mrmanfreee/LightioCurtainsController/3d-models/PulleyBlock/asm.gif

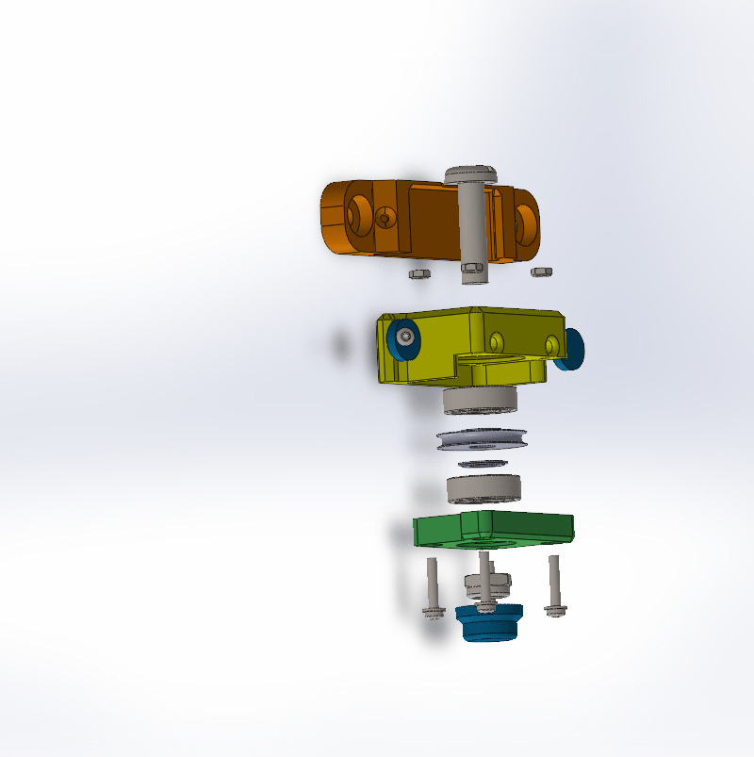
3d-models/PulleyBlock/asm.gif
