mrmanfreee/LightioCurtainsController/3d-models/PulleyBlock/asm.png

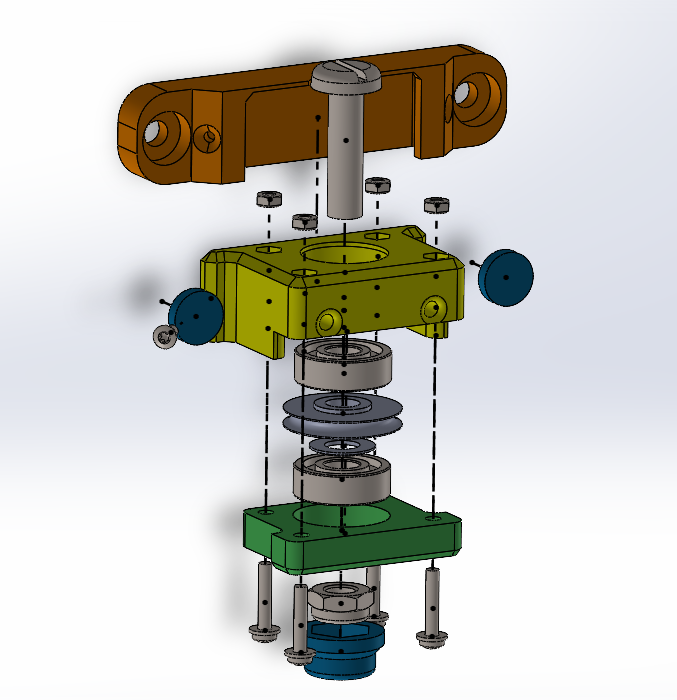
3d-models/PulleyBlock/asm.png
