mrmanfreee/LightioCurtainsController/3d-models/AdditionalDetails/small.3mf

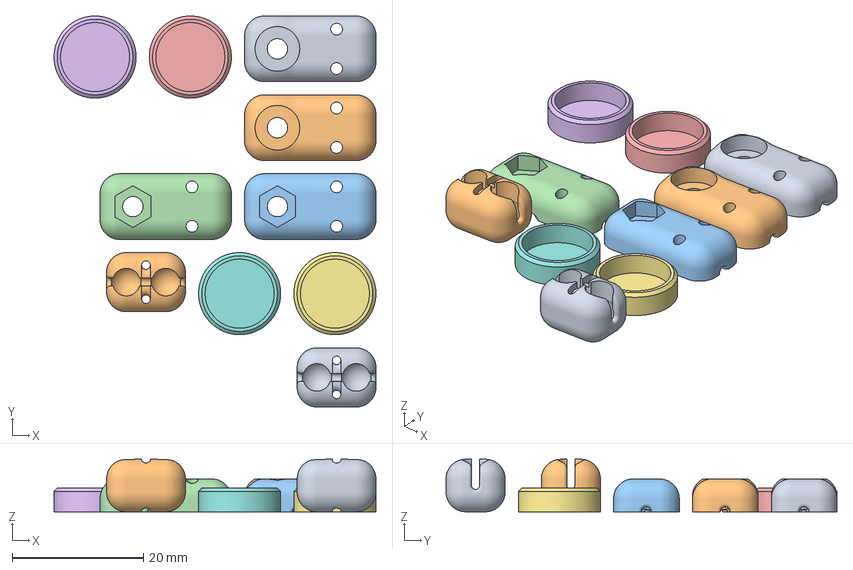
[picture p16: CAD file, 2026-11-05]
3d-models/AdditionalDetails/small.3mf
49.0 x 59.5 x 8.00 mm
connectorTopBall x 2
connectorBtmBall x 2
cap x 4
presser x 2
