mrmanfreee/LightioCurtainsController/3d-models/Controller/MirrorGateBall.STEP

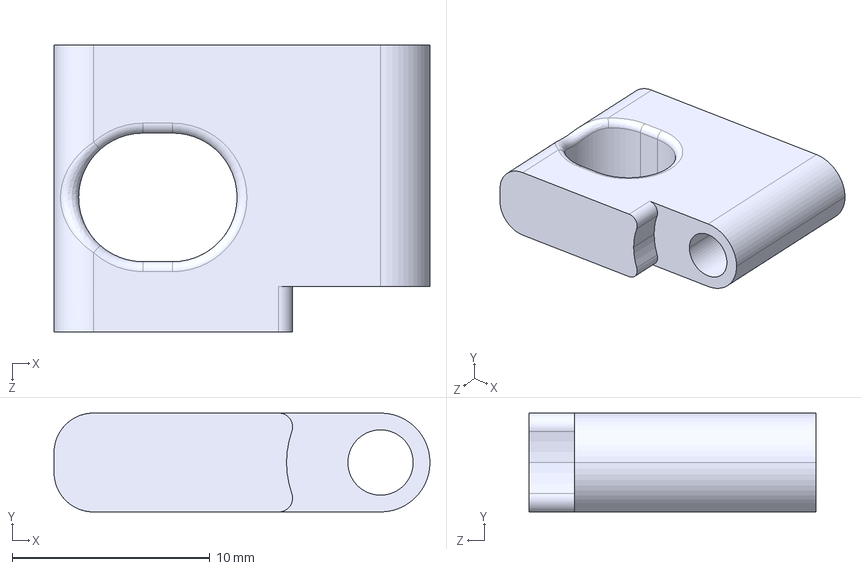
[picture p17: CAD file, 2026-11-05]
3d-models/Controller/MirrorGateBall.STEP
19.0 x 5.00 x 14.5 mm
