mrmanfreee/LightioCurtainsController/3d-models/Remote/buttonA.STEP

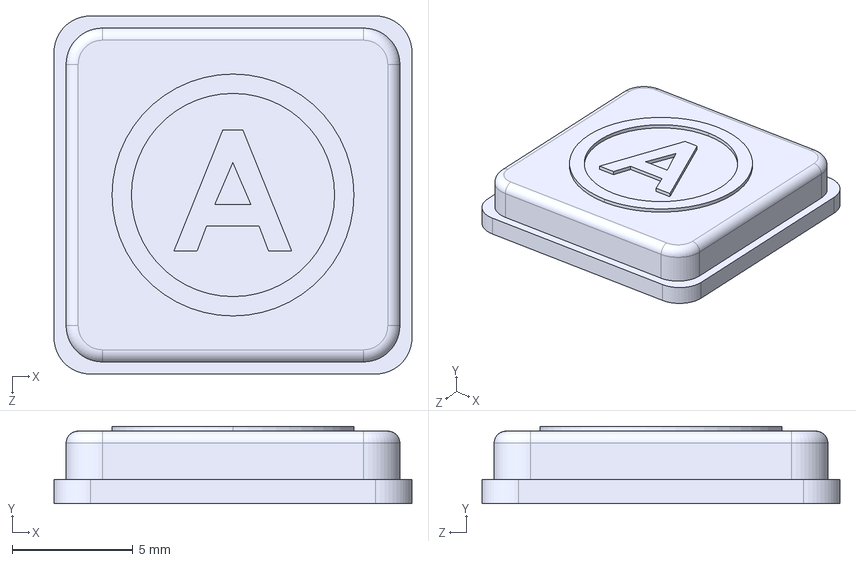
[picture p18: CAD file, 2026-11-05]
3d-models/Remote/buttonA.STEP
14.8 x 3.20 x 14.8 mm
