mrmanfreee/LightioCurtainsController/3d-models/AdditionalDetails/connectorTopBall.STEP

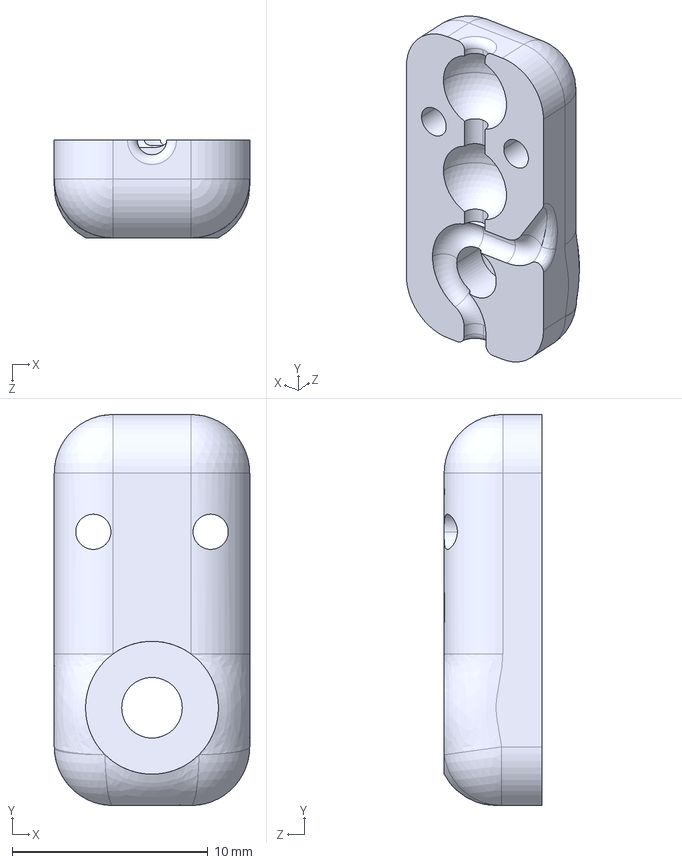
[picture p19: CAD file, 2026-11-05]
3d-models/AdditionalDetails/connectorTopBall.STEP
10.0 x 20.0 x 5.00 mm
