mrmanfreee/LightioCurtainsController/3d-models/Controller/CoverGearbox.STEP

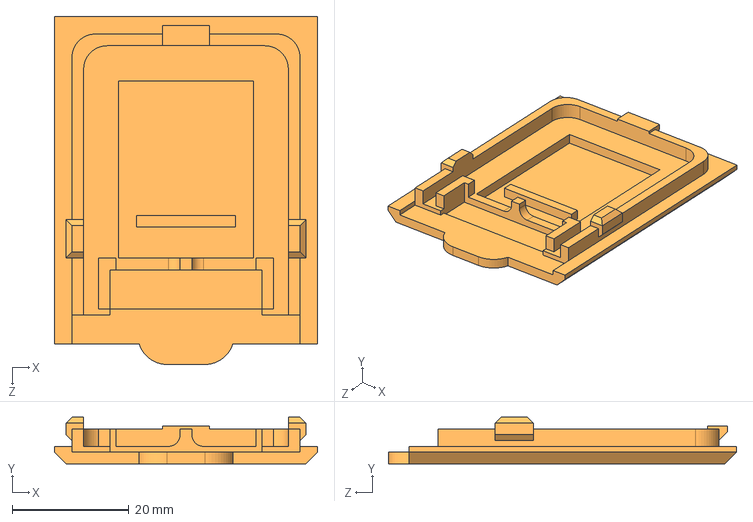
[picture p20: CAD file, 2026-11-05]
3d-models/Controller/CoverGearbox.STEP
45.0 x 8.00 x 59.5 mm
