mrmanfreee/LightioCurtainsController/3d-models/PulleyBlock/hood.STEP

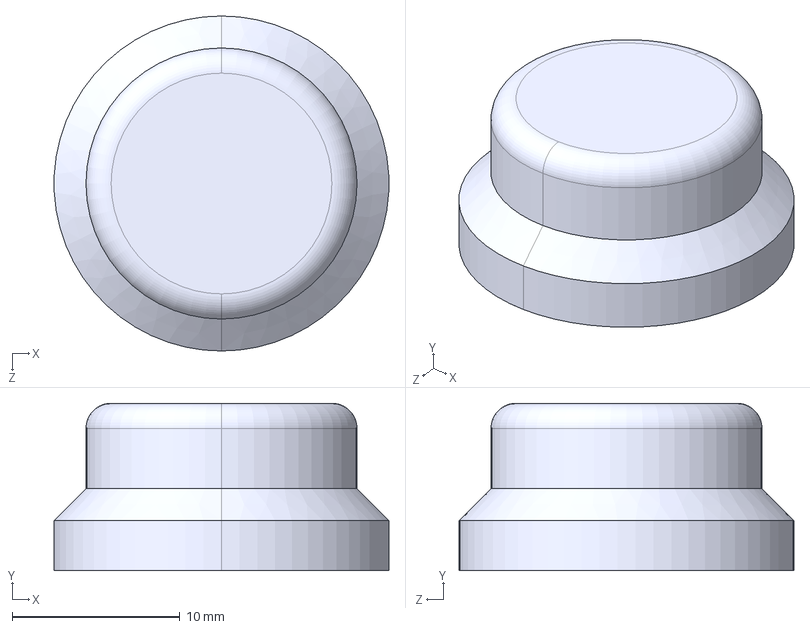
[picture p21: CAD file, 2026-11-05]
3d-models/PulleyBlock/hood.STEP
20.0 x 10.00 x 20.0 mm
