mrmanfreee/LightioCurtainsController/3d-models/Remote/back.STEP

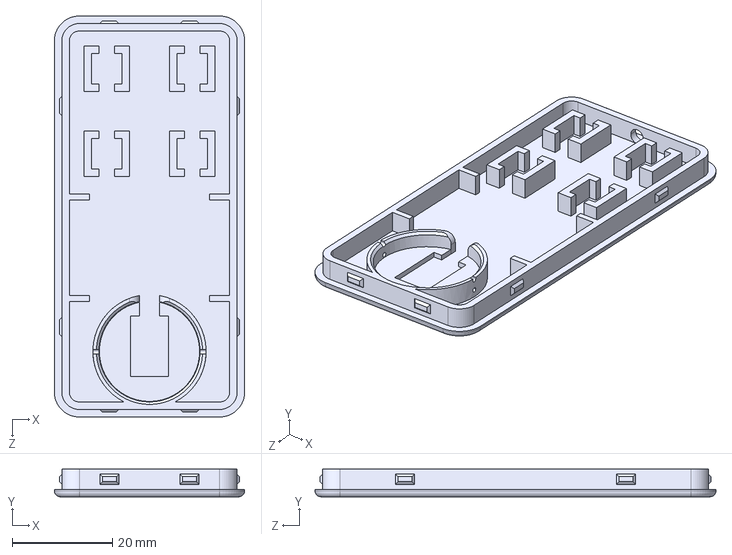
[picture p22: CAD file, 2026-11-05]
3d-models/Remote/back.STEP
38.0 x 5.50 x 80.0 mm
