mrmanfreee/LightioCurtainsController/3d-models/AdditionalDetails/presser.STEP

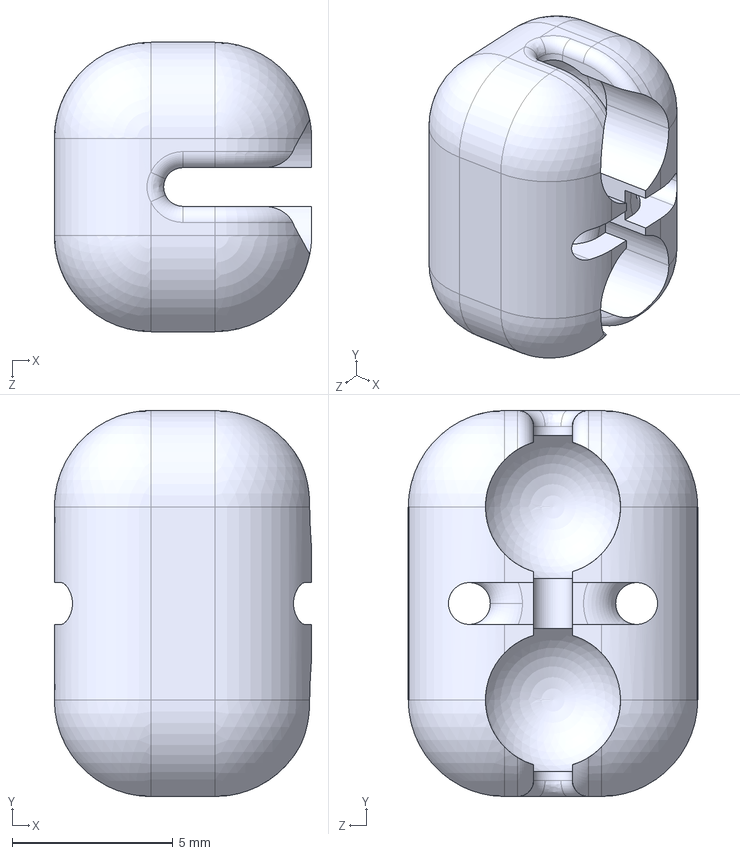
[picture p23: CAD file, 2026-11-05]
3d-models/AdditionalDetails/presser.STEP
8.00 x 12.0 x 9.00 mm
