mrmanfreee/LightioCurtainsController/3d-models/Controller/Device.3mf

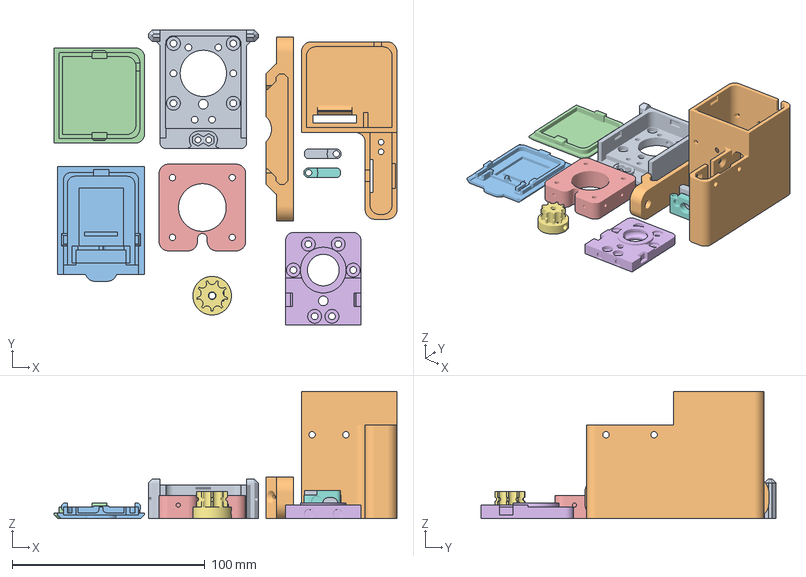
[picture p24: CAD file, 2026-11-05]
3d-models/Controller/Device.3mf
177.9 x 153.0 x 66.0 mm
bodyBall
Mount
CoverBall
electronicBoxCover
NemaExtensor
separatorBall
gear9
GateBall
MirrorGateBall
electronicBox
