mrmanfreee/LightioCurtainsController/3d-models/PulleyBlock/Mount.STEP

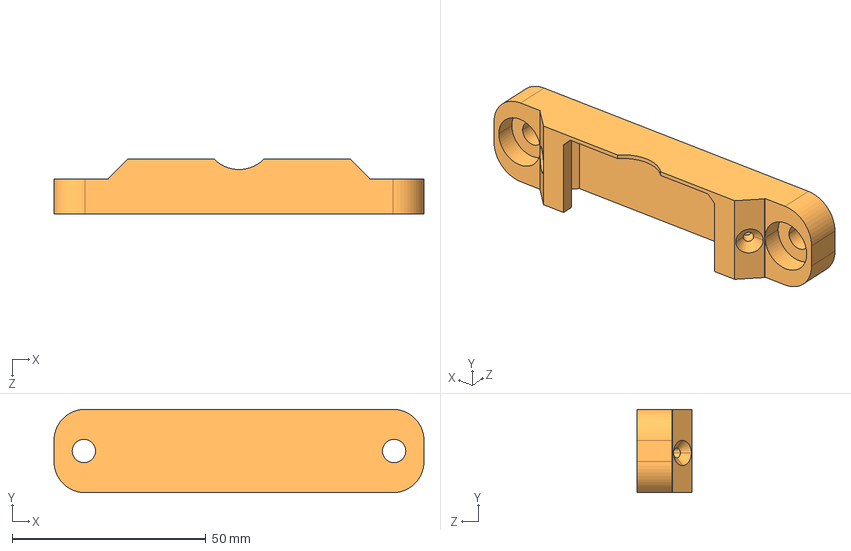
[picture p25: CAD file, 2026-11-05]
3d-models/PulleyBlock/Mount.STEP
95.4 x 21.5 x 14.2 mm
