mrmanfreee/LightioCurtainsController/3d-models/Remote/ir_buttons.3mf

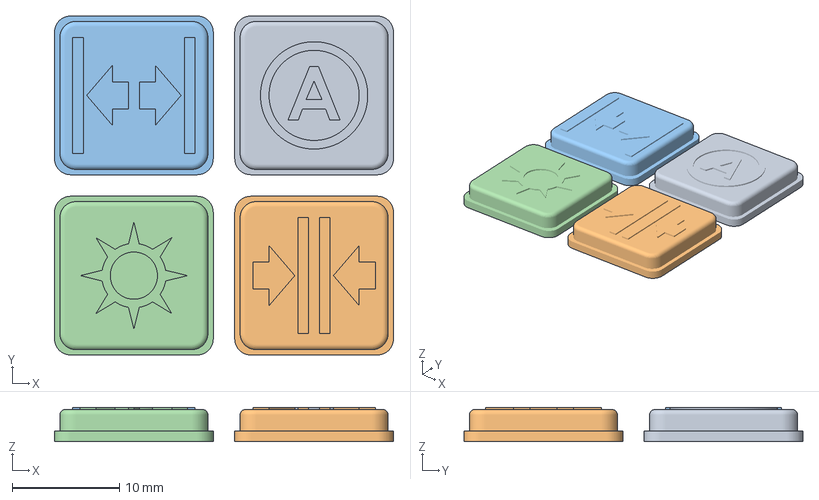
[picture p26: CAD file, 2026-11-05]
3d-models/Remote/ir_buttons.3mf
31.6 x 31.6 x 3.20 mm
buttonA
buttonCurtainsArrowClose
buttonCurtainsArrowOpen2
buttonSun
