mrmanfreee/LightioCurtainsController/3d-models/Controller/electronicBox.STEP

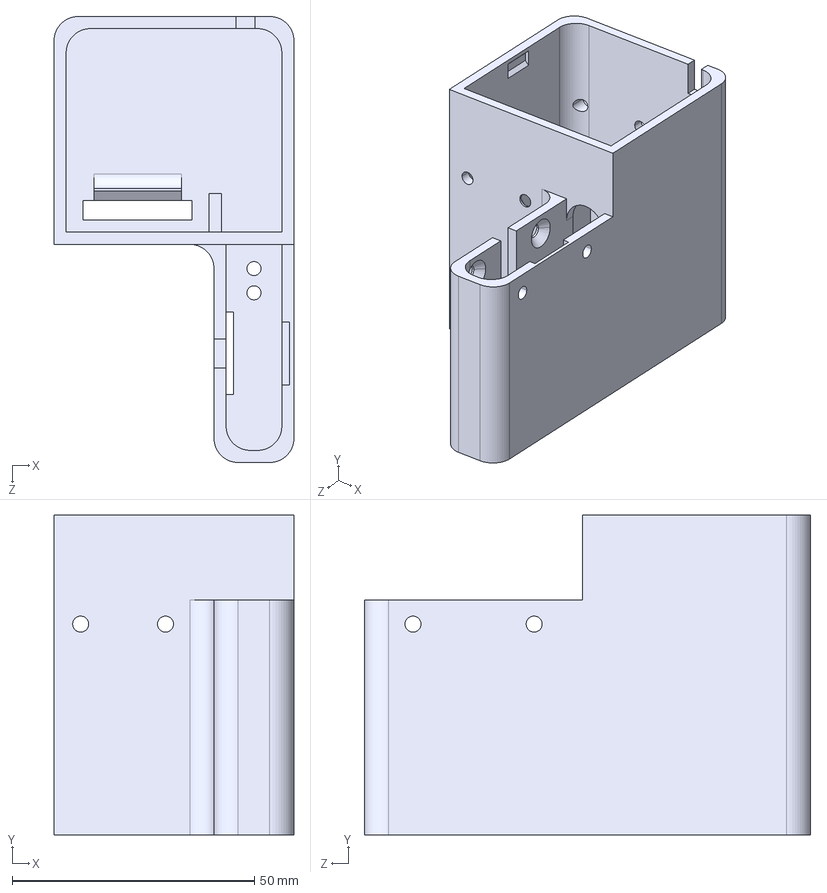
[picture p28: CAD file, 2026-11-05]
3d-models/Controller/electronicBox.STEP
49.5 x 66.0 x 92.0 mm
