mrmanfreee/LightioCurtainsController/3d-models/PulleyBlock/body.STEP

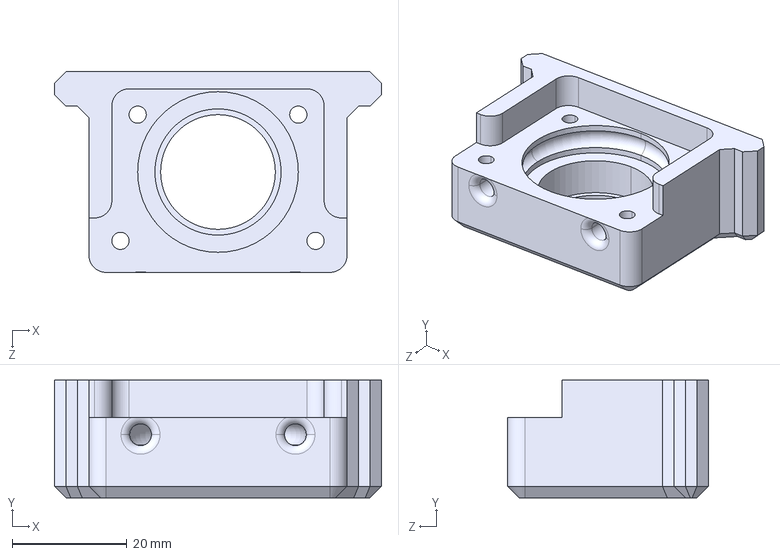
[picture p29: CAD file, 2026-11-05]
3d-models/PulleyBlock/body.STEP
57.0 x 20.5 x 35.0 mm
