mrmanfreee/LightioCurtainsController/3d-models/Remote/front.STEP

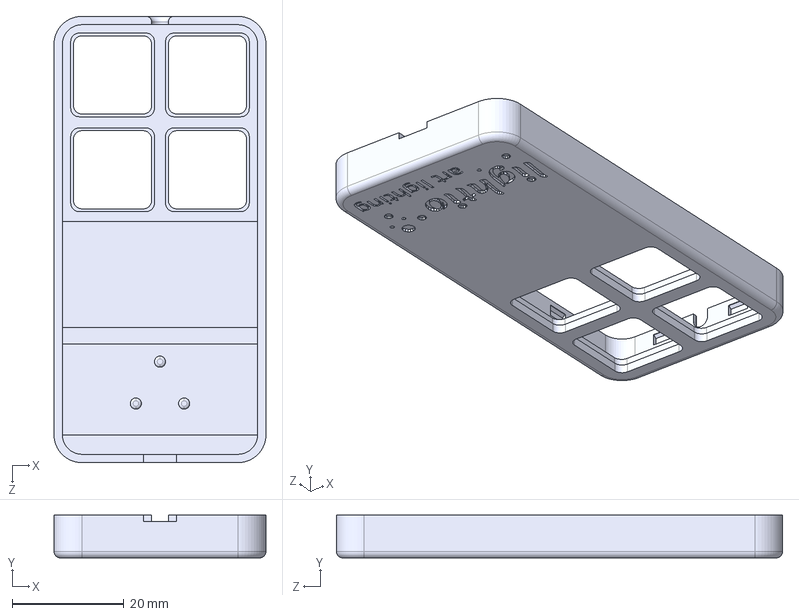
[picture p30: CAD file, 2026-11-05]
3d-models/Remote/front.STEP
38.0 x 7.70 x 80.0 mm
