mrmanfreee/LightioCurtainsController/3d-models/AdditionalDetails/cap.STEP

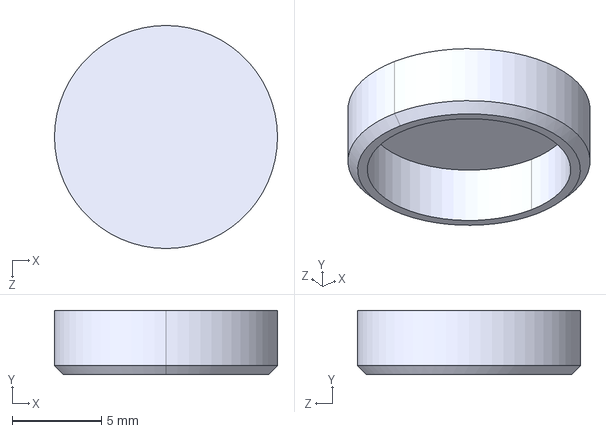
[picture p31: CAD file, 2026-11-05]
3d-models/AdditionalDetails/cap.STEP
12.5 x 3.60 x 12.5 mm
