mrmanfreee/LightioCurtainsController/3d-models/Controller/gear9.STEP

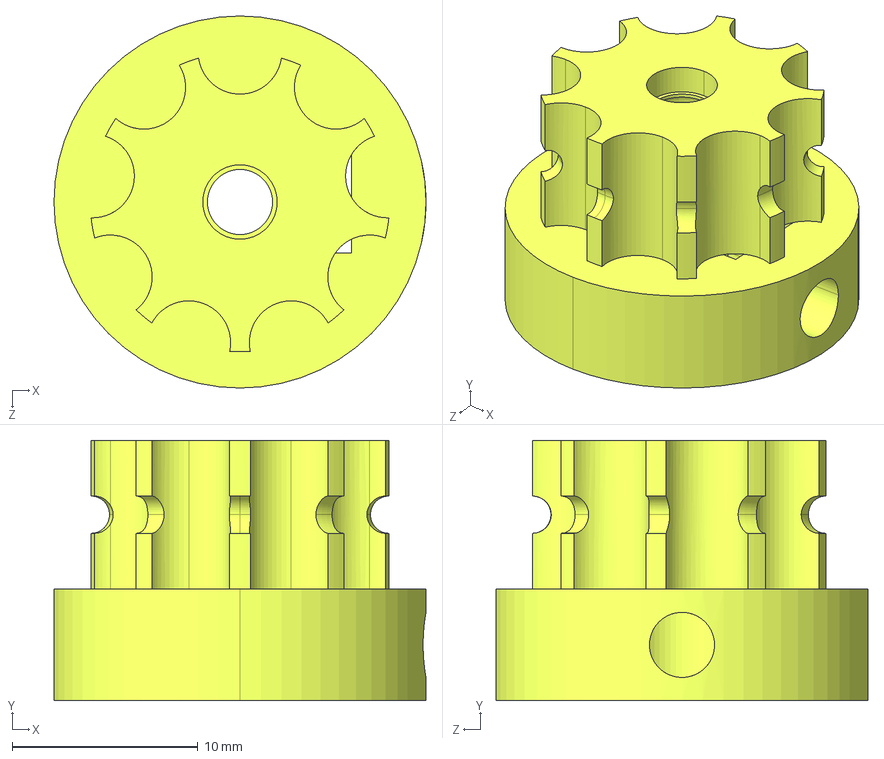
[picture p32: CAD file, 2026-11-05]
3d-models/Controller/gear9.STEP
20.0 x 14.0 x 20.0 mm
