mrmanfreee/LightioCurtainsController/3d-models/PulleyBlock/cover_.STEP

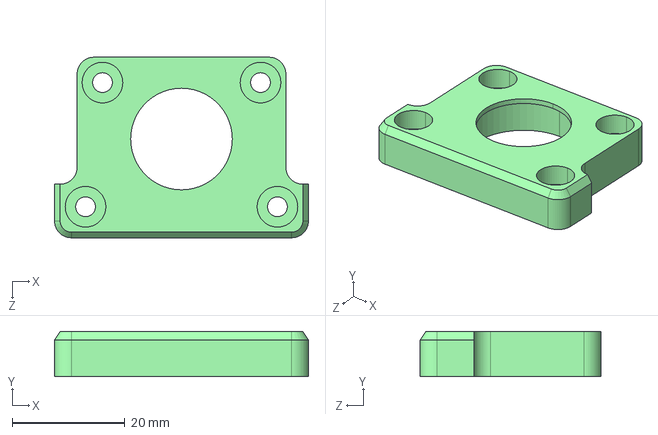
[picture p33: CAD file, 2026-11-05]
3d-models/PulleyBlock/cover_.STEP
45.0 x 8.00 x 32.0 mm
