mrmanfreee/LightioCurtainsController/3d-models/Controller/NemaExtender.STEP

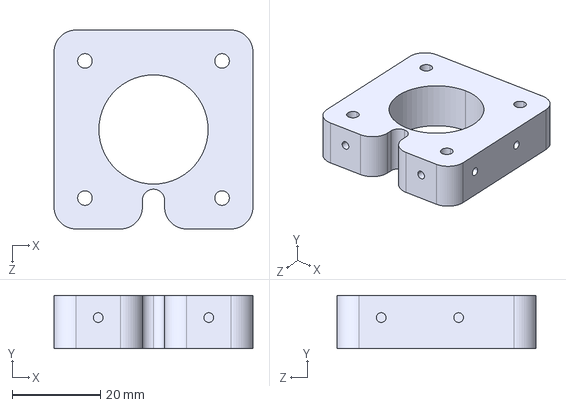
[picture p34: CAD file, 2026-11-05]
3d-models/Controller/NemaExtender.STEP
45.0 x 12.0 x 45.0 mm
