mrmanfreee/LightioCurtainsController/3d-models/PulleyBlock/pulley.STEP

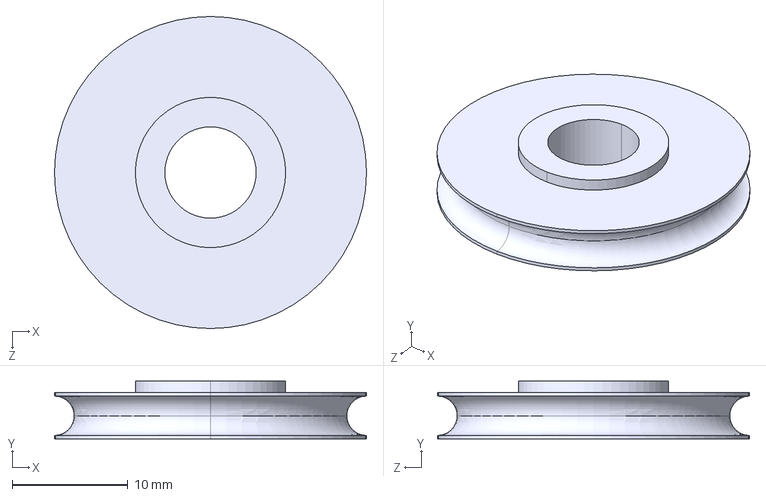
[picture p35: CAD file, 2026-11-05]
3d-models/PulleyBlock/pulley.STEP
27.0 x 5.00 x 27.0 mm
