mrmanfreee/LightioCurtainsController/3d-models/Controller/electronicBoxCover.STEP

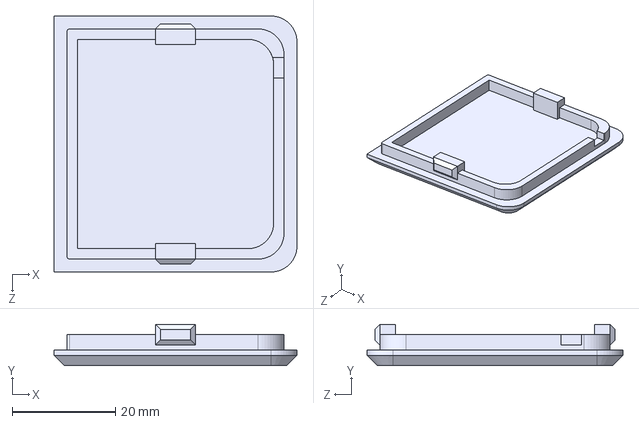
[picture p36: CAD file, 2026-11-05]
3d-models/Controller/electronicBoxCover.STEP
47.0 x 8.00 x 49.5 mm
