mrmanfreee/LightioCurtainsController/3d-models/Remote/ir_body.3mf

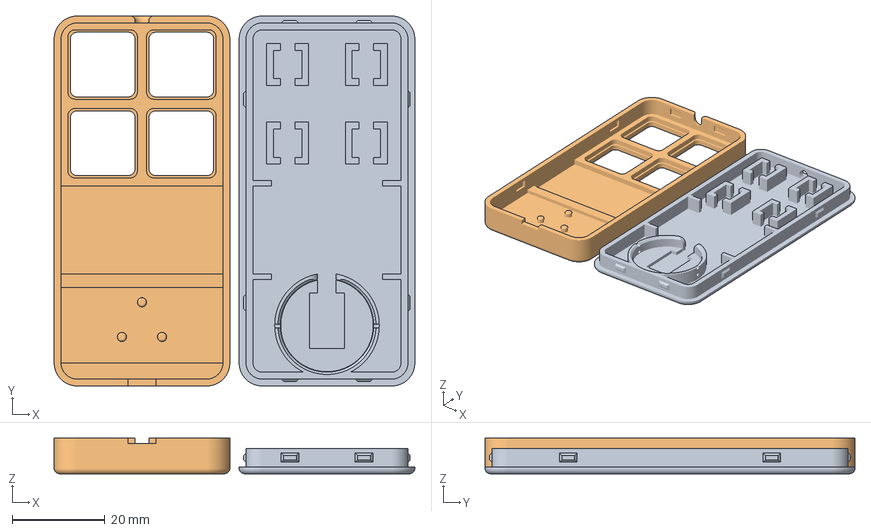
[picture p37: CAD file, 2026-11-05]
3d-models/Remote/ir_body.3mf
78.0 x 80.0 x 7.70 mm
back
front
