mrmanfreee/LightioCurtainsController/3d-models/Controller/Body.STEP

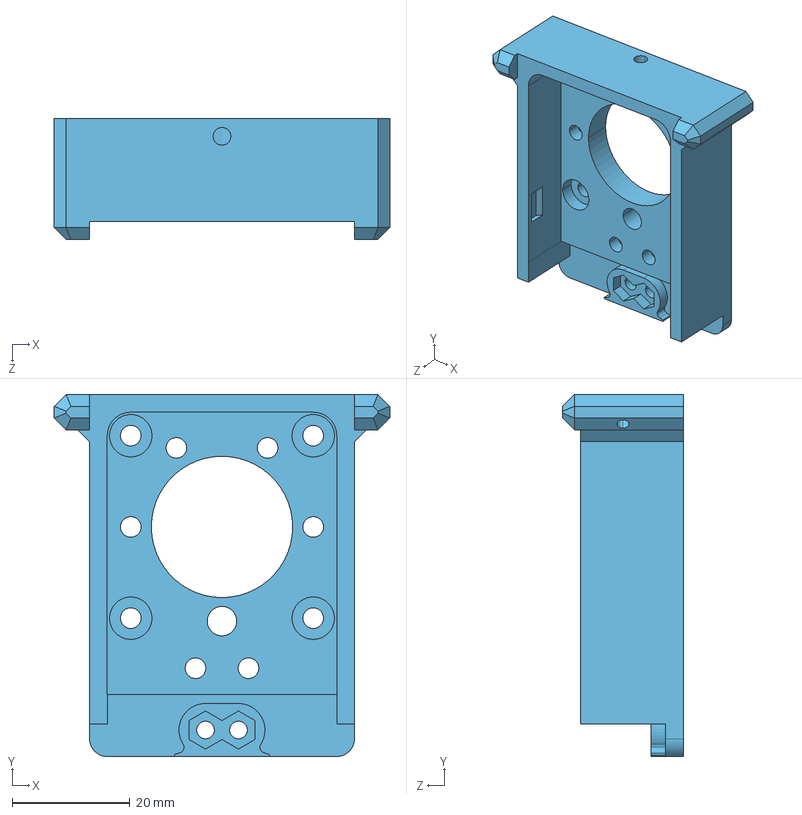
[picture p38: CAD file, 2026-11-05]
3d-models/Controller/Body.STEP
57.0 x 61.5 x 20.5 mm
