mrmanfreee/LightioCurtainsController/3d-models/Controller/Separator.STEP

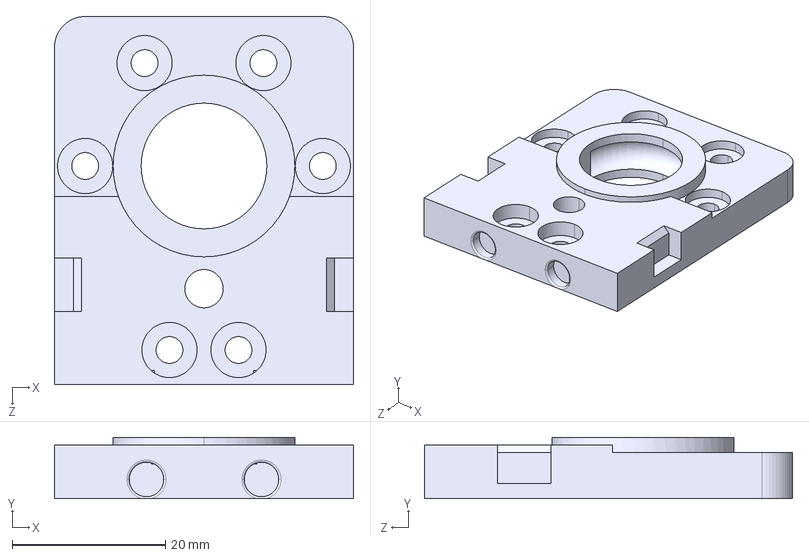
[picture p39: CAD file, 2026-11-05]
3d-models/Controller/Separator.STEP
39.0 x 8.00 x 48.0 mm
