mrmanfreee/LightioCurtainsController/(list of files, cad)

Other CAD files:
3d-models/Remote/buttonSun.STEP
3d-models/Remote/buttonCurtainsArrowClose.STEP
3d-models/Controller/WallMount.STEP
3d-models/Remote/buttonCurtainsArrowOpen2.STEP
3d-models/Controller/GateBall.STEP
3d-models/PulleyBlock/pulley.3mf
3d-models/PulleyBlock/washer.STEP
